mattvenn/lucy-ren-badge/README.md

# design

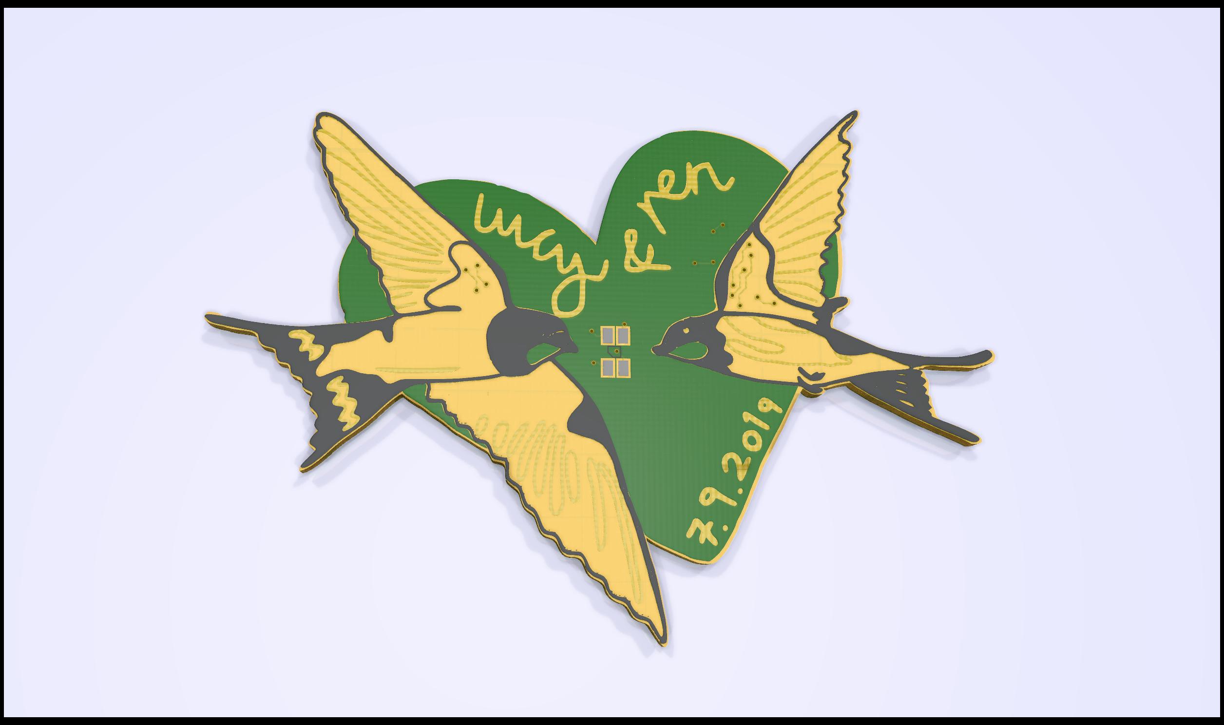
[picture p1: design/lucy-ren-badge.jpg]
design


1300 dpi to convert from Rachel file to 71x51mm badge
$63 for 100 from pcbway

* mask - normal then edit file to change layer
* silk - invert
* copper - invert then edit file
* outline - fill black, export png, import inkscape, path->trace outline, scale 5.66, export DXF

reduced size of master image by 4 to 1008x756

## feedback

* had to tell pcbway to keep silkscreen on copper with no mask (otherwise would normally be a design error and they remove it)
* should have used mask on silk areas anyway, as it doesn't stick well onto plain copper
* should have removed mask on the back that matches with removed mask on the front as the mask on the back makes the FR4 look green

# BOM

* pins - ordered from amazon
* slide switch - farnell
* battery - ordered amazon
* battery holder - farnell
* attiny88 - check footprint & parts I have - done is correct
* 0.1u x 1  - dnp 
* 1u x 1 - dnp
* R1: 10k x 1 - farnell 
* R2: 47R x 1 - farnell

# Assembly notes

## back side

* solder microchip first. Ensure pin 1 (marked with a small circle on the package) is next to the p1 marking on the board.
* solder R1 (10k) and R2 (47R)
* solder the switch
* solder the battery holder

## front side

* solder LED. ensure the chamfered corner matches the drawing in the silk screen

## programming

* change to the firmware directory
* use an AVR ICSP programmer with pogo pins to connect to the board (or solder a header)
* you might need to edit the Makefile to change the parameters for your programmer (line 32)
* insert the battery (+ side up)
* turn on the power (set slide switch to 'on')
* make sure pin1 of the programmer matches pin1 of the header (marked by chamfered corner)
* to program fuses: make fuse
* to flash the software: make flash

# firmware

* "bitbanged" pwm with interrupt on timer1
* needed to set BOD level lower in fuses for 3v battery
