mattvenn/lucy-ren-badge/design/black-silk.png

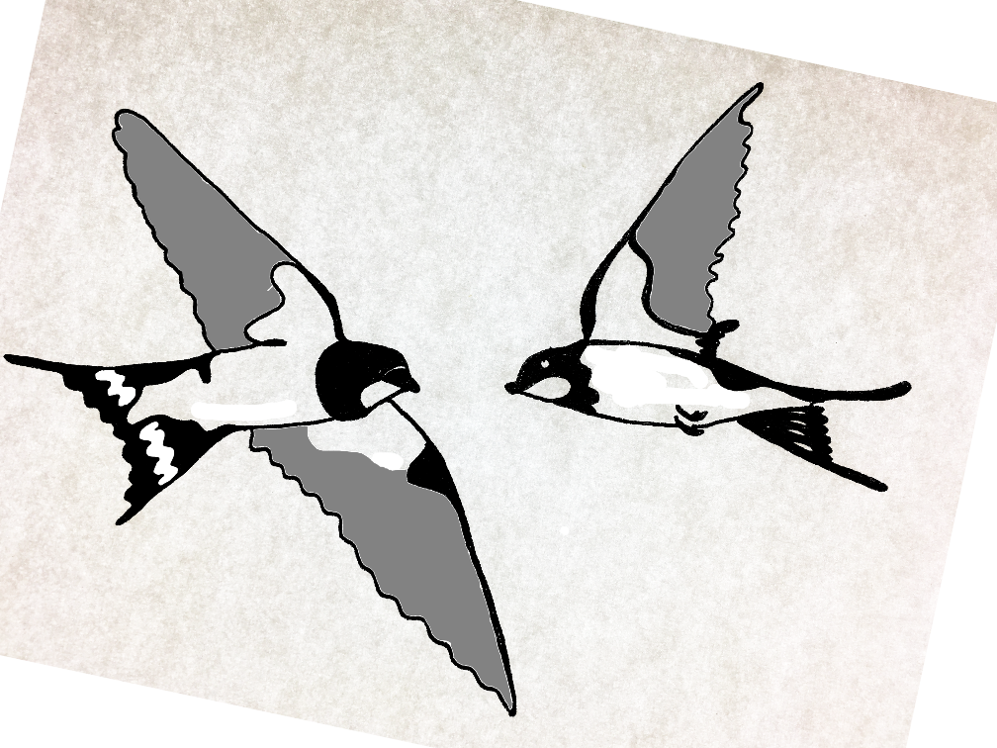
design/black-silk.png
