mattvenn/lucy-ren-badge/design/copper.png

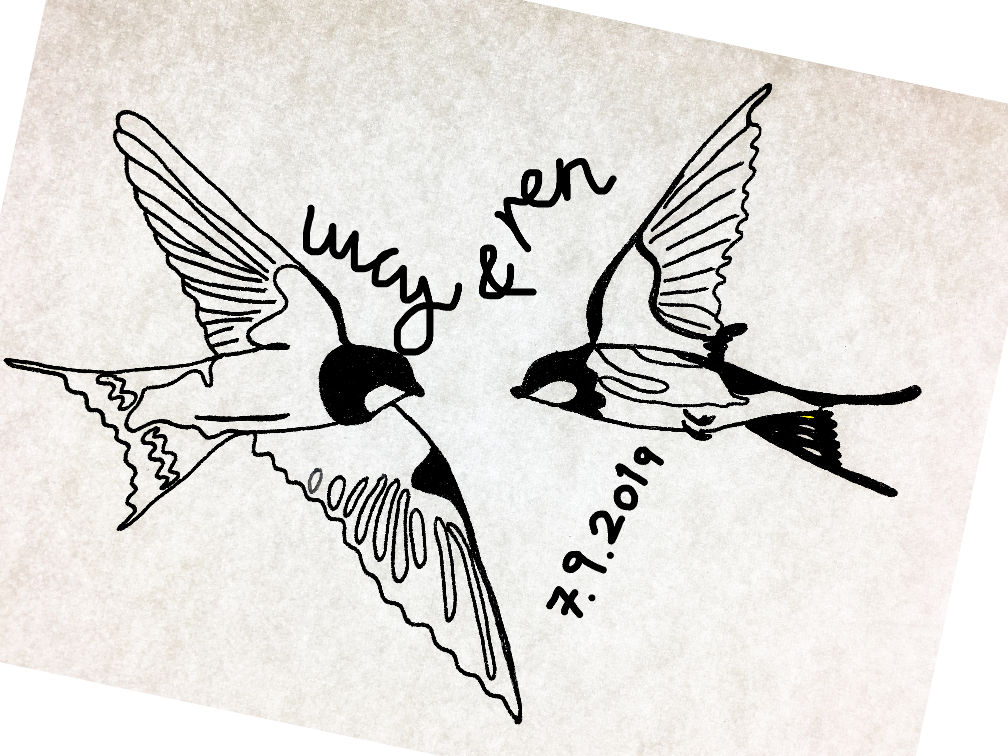
design/copper.png
