mattvenn/lucy-ren-badge/design/outline.png

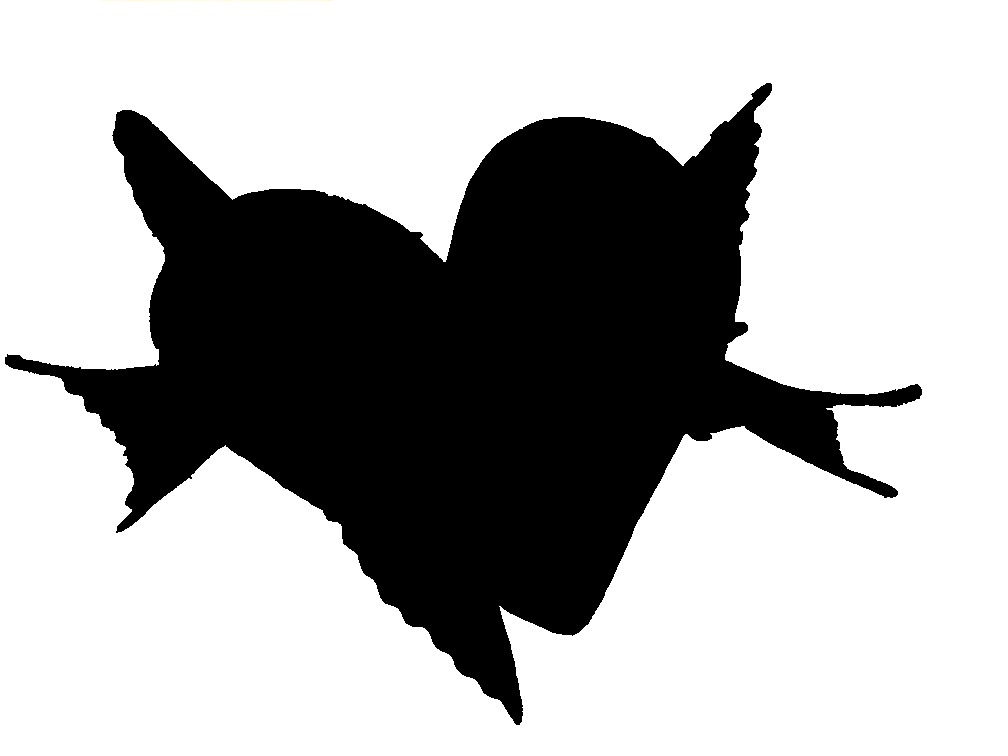
design/outline.png
