mattvenn/lucy-ren-badge/design/red-mask.png

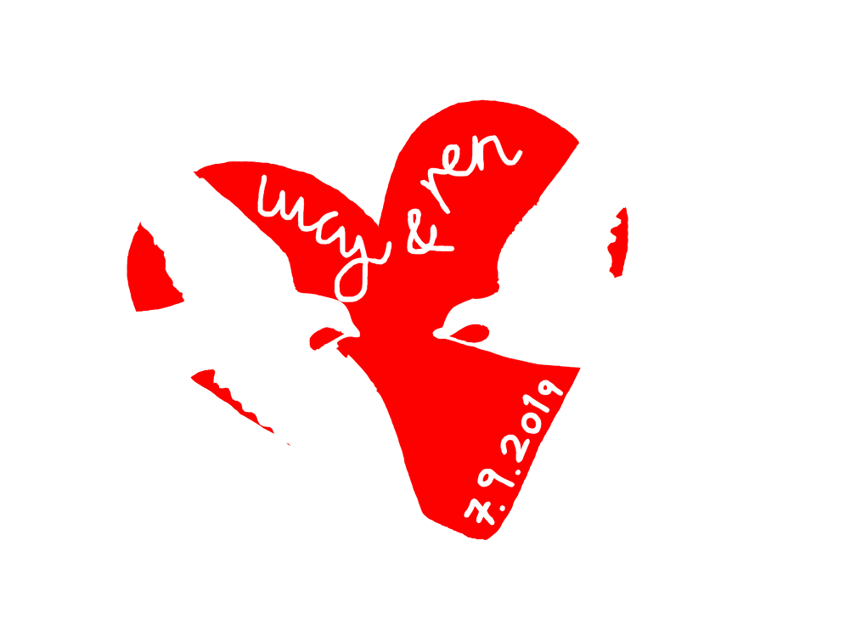
design/red-mask.png
