mattvenn/lucy-ren-badge/design/outline.dxf

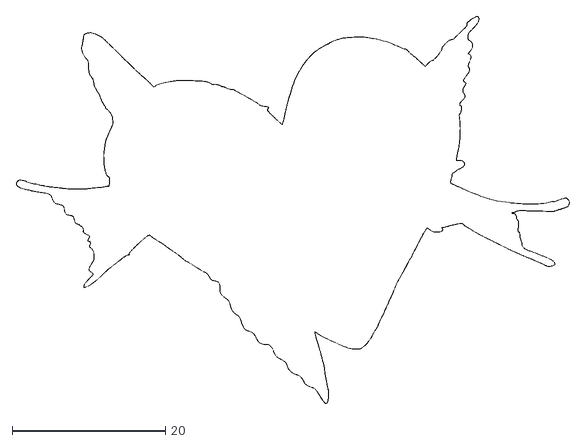
[picture p6: CAD file, 2019-09-03]
design/outline.dxf
72.1 x 50.5
