mattvenn/lucy-ren-badge/pcb/lucy-ren-badge.kicad_pcb

## KiCad design pcb/lucy-ren-badge.kicad_pcb (2019-09-03)

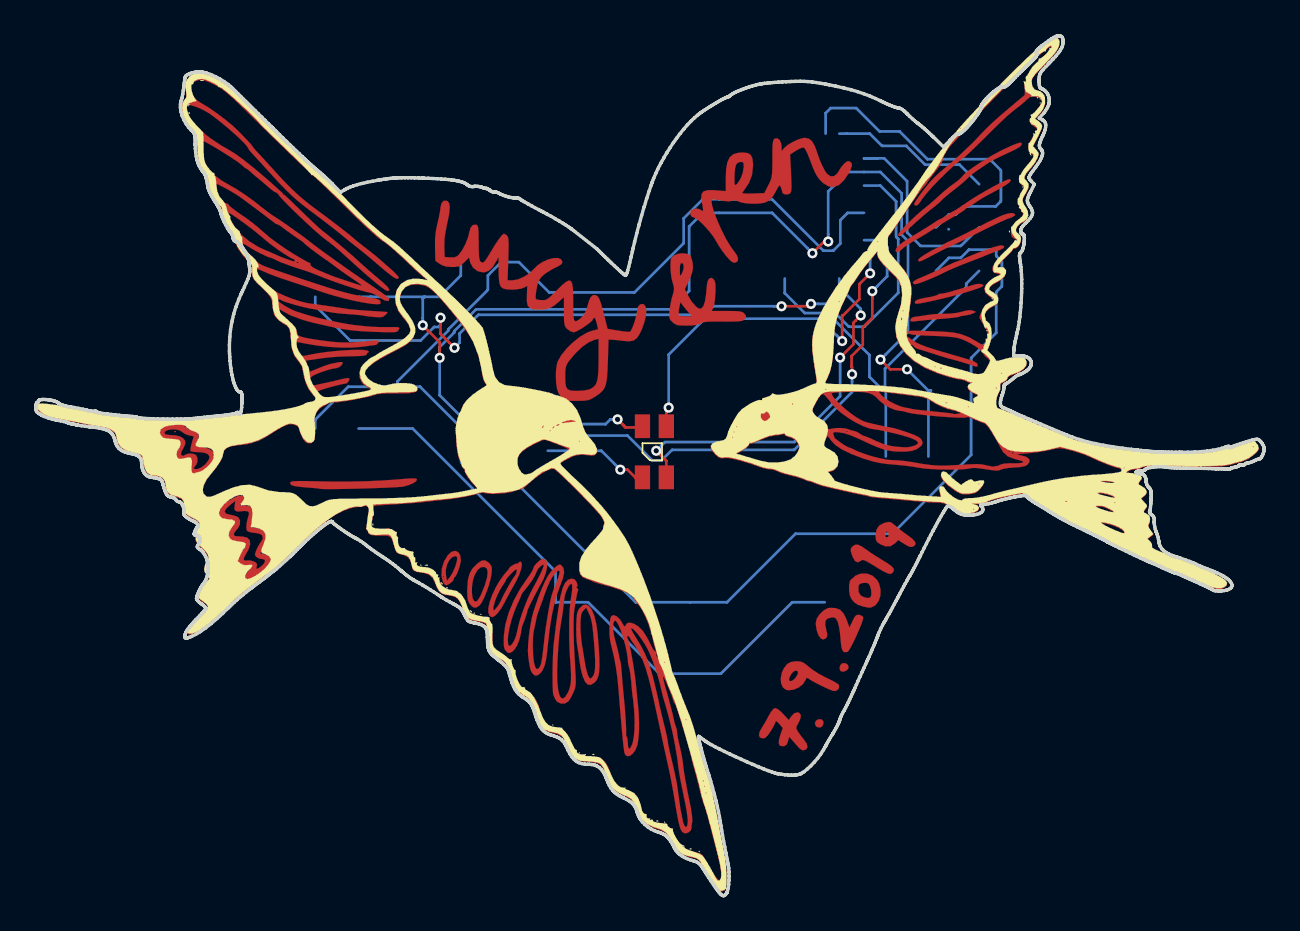
[picture p7: board lucy-ren-badge.kicad_pcb from above]

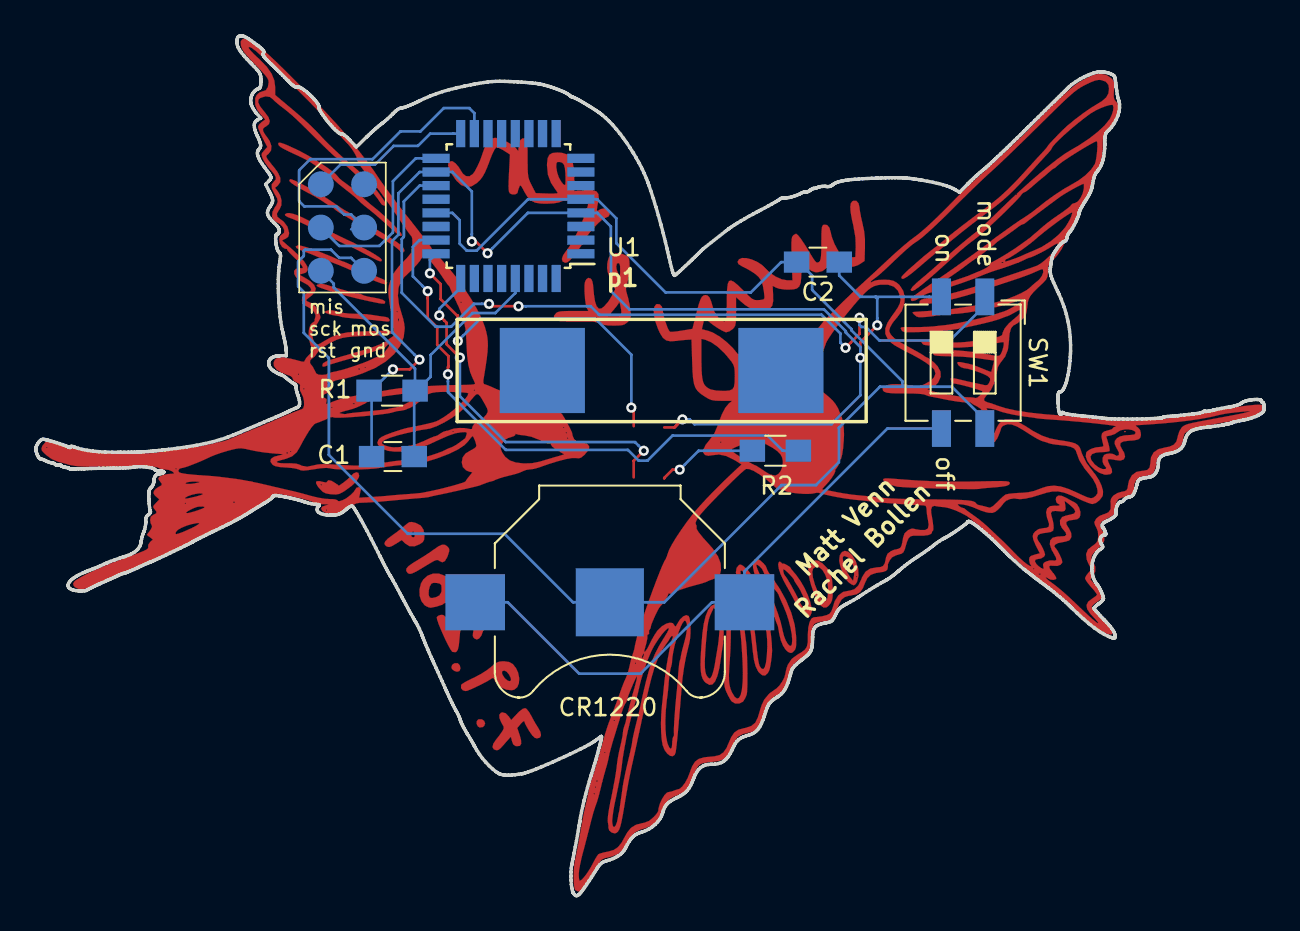
[picture p8: board lucy-ren-badge.kicad_pcb from below]

Board: 2 copper layers, 72.1 x 50.5 mm, 9 parts (8 on the bottom side), 12 nets.

Parts:
C1, C2: C; C_0805_HandSoldering
CR1220: Battery_Cell; Keystone_3000_1x12mm-CoinCell
J1: Conn_02x03_Odd_Even; icsp-2.54-smt
R1, R2: R; R_0805_HandSoldering
SW1: SW_DIP_x02; SW_DIP_SPSTx02_Slide_6.7x6.64mm_W6.73mm_P2.54mm_LowProfile_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
U1: ATTINY88-AU; TQFP-32_7x7mm_Pitch0.8mm
U2: rgbled; 3528-4p

Connections:
/b1: U1.25, U2.6
/g1: U1.24, U2.4
/miso: J1.1, U1.16
/mode: SW1.1, U1.19
/mosi: J1.4, U1.15
/r1: R2.2, U2.5
/reset: C1.2, J1.5, R1.1, U1.29
/sck: J1.3, U1.17
GND: C2.2, CR1220.2, J1.6, SW1.4, U1.5, U1.21
unnamed: CR1220.1, SW1.3
unnamed: R2.1, U1.23
VCC: C1.1, C2.1, R1.2, SW1.2, U1.4, U1.18, U2.1
