mattvenn/lucy-ren-badge/(commit log)

2019-09-02 pwm and basic modes
2019-09-03 changed BOD level to 1.8v - 2.7 was too close to the 3v supply of battery
2019-09-03 include image
    [lucy-ren-badge.kicad_pcb, lucy-ren-badge.sch, outline.dxf]
2019-09-03 added feedback from real pcbs
2019-09-11 assembly notes
